Pau1oo/nrf52840-physiological-monitor/docs/Макет.pdf

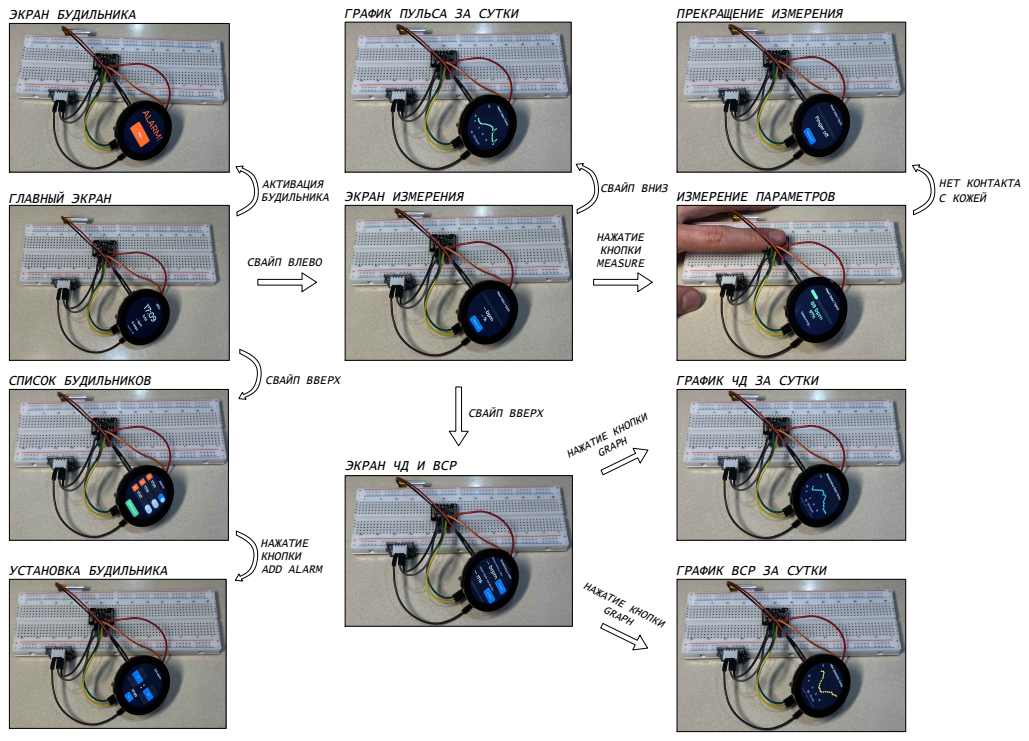
[picture p1: page 1]
ГЛАВНЫЙ ЭКРАН; СПИСОК БУДИЛЬНИКОВ; УСТАНОВКА БУДИЛЬНИКА; СВАЙП ВЛЕВО; ЭКРАН ИЗМЕРЕНИЯ; СВАЙП ВНИЗ; СВАЙП ВВЕРХ; ИЗМЕРЕНИЕ ПАРАМЕТРОВ; ЭКРАН БУДИЛЬНИКА; ПРЕКРАЩЕНИЕ ИЗМЕРЕНИЯ; НАЖАТИЕ КНОПКИ; НЕТ КОНТАКТА С КОЖЕЙ; A'' A/ARM

ГРАФИК ПУЛЬСА ЗА СУТКИ

ГРАФИК ЧД ЗА СУТКИ

ЭКРАН ЧД И ВСР

ГРАФИК ВСР ЗА СУТКИ
