Pau1oo/nrf52840-physiological-monitor/docs/Принципиальная схема.pdf

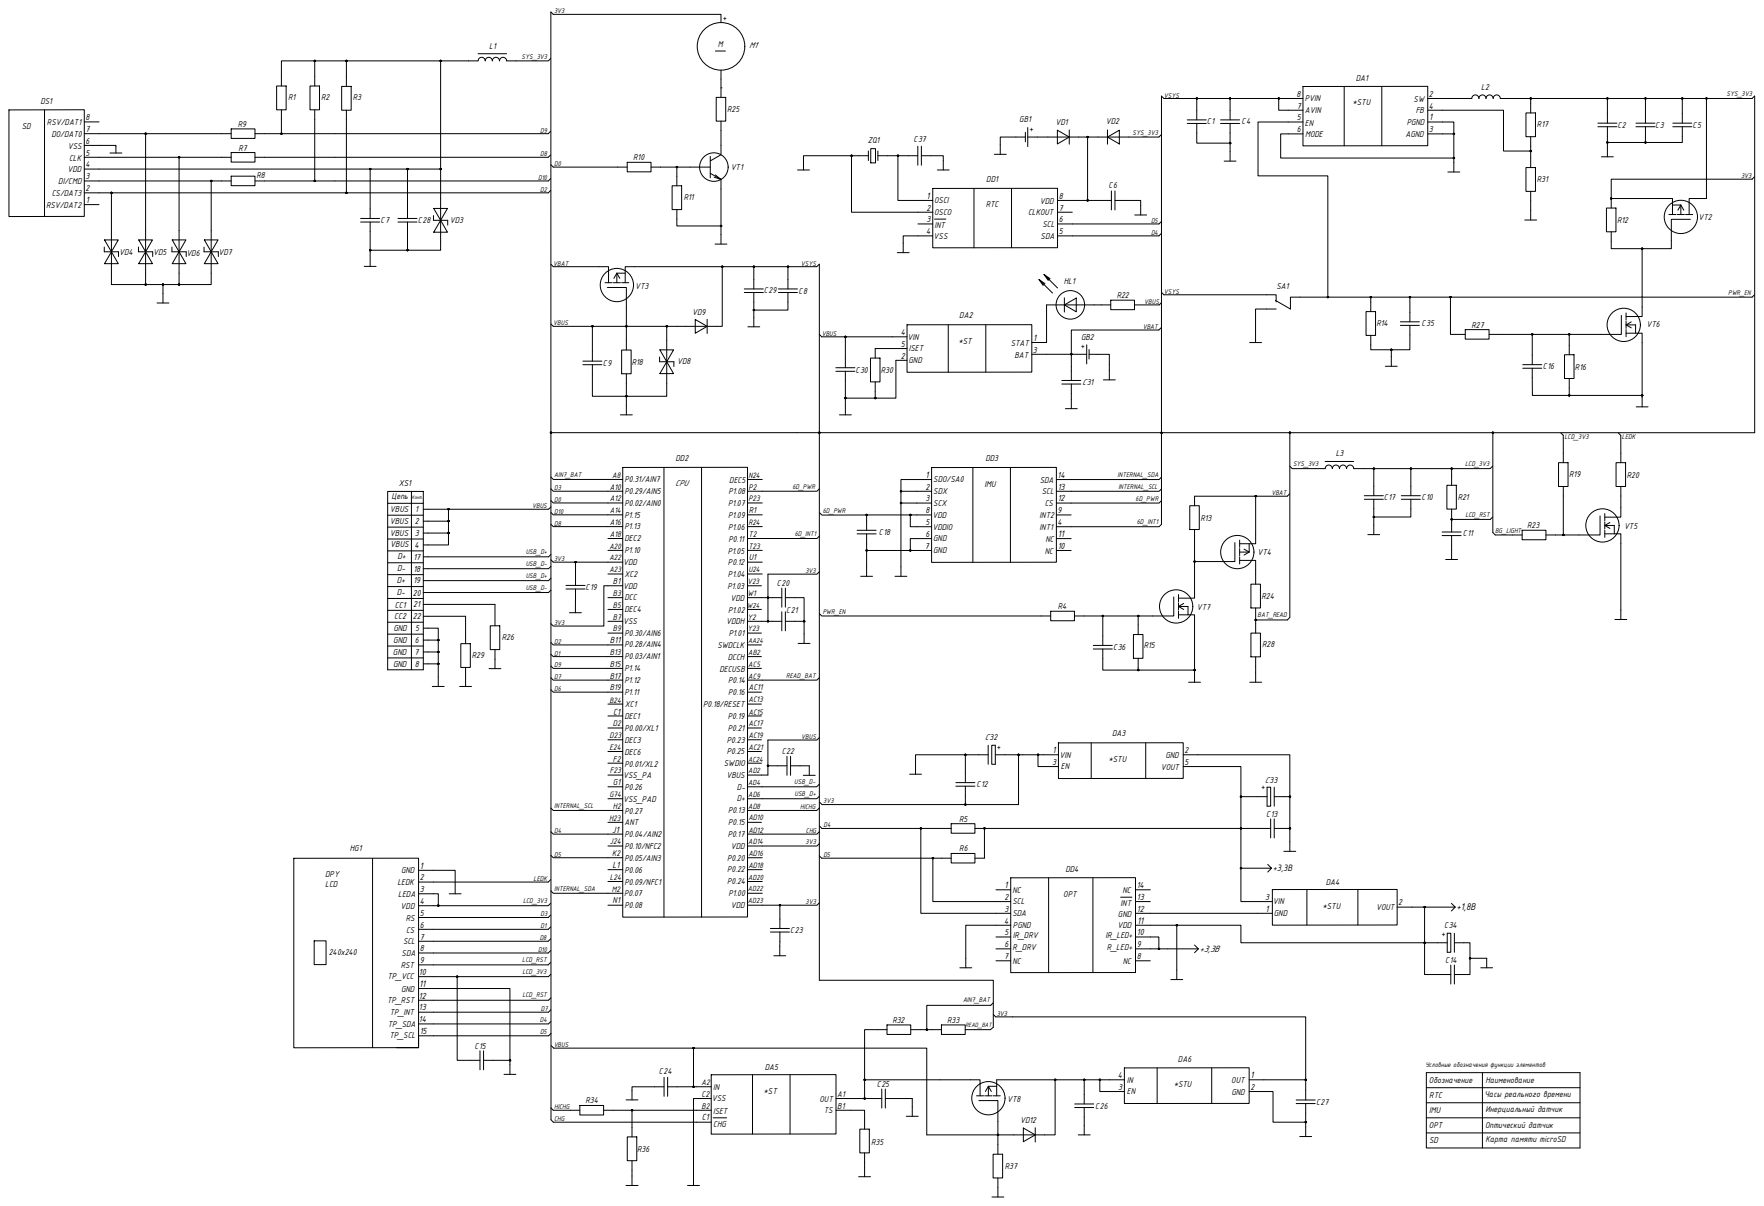
[picture p2: page 1]

DD2 | DD3 | VBAT | LCD_3V3

SDO/SA0 SDX SCX VDD VDDIO GND GND | IMU | SDA SCL CS INT2 INT1 NC

5 | | 10

Условные обозначения функции элементов

IN | OUT

Обозначение | Наименование

IN VSS ISET | *ST | OUT TS

IMU | Инерциальный датчик
