Pau1oo/nrf52840-physiological-monitor/docs/Схемы подключения.pdf

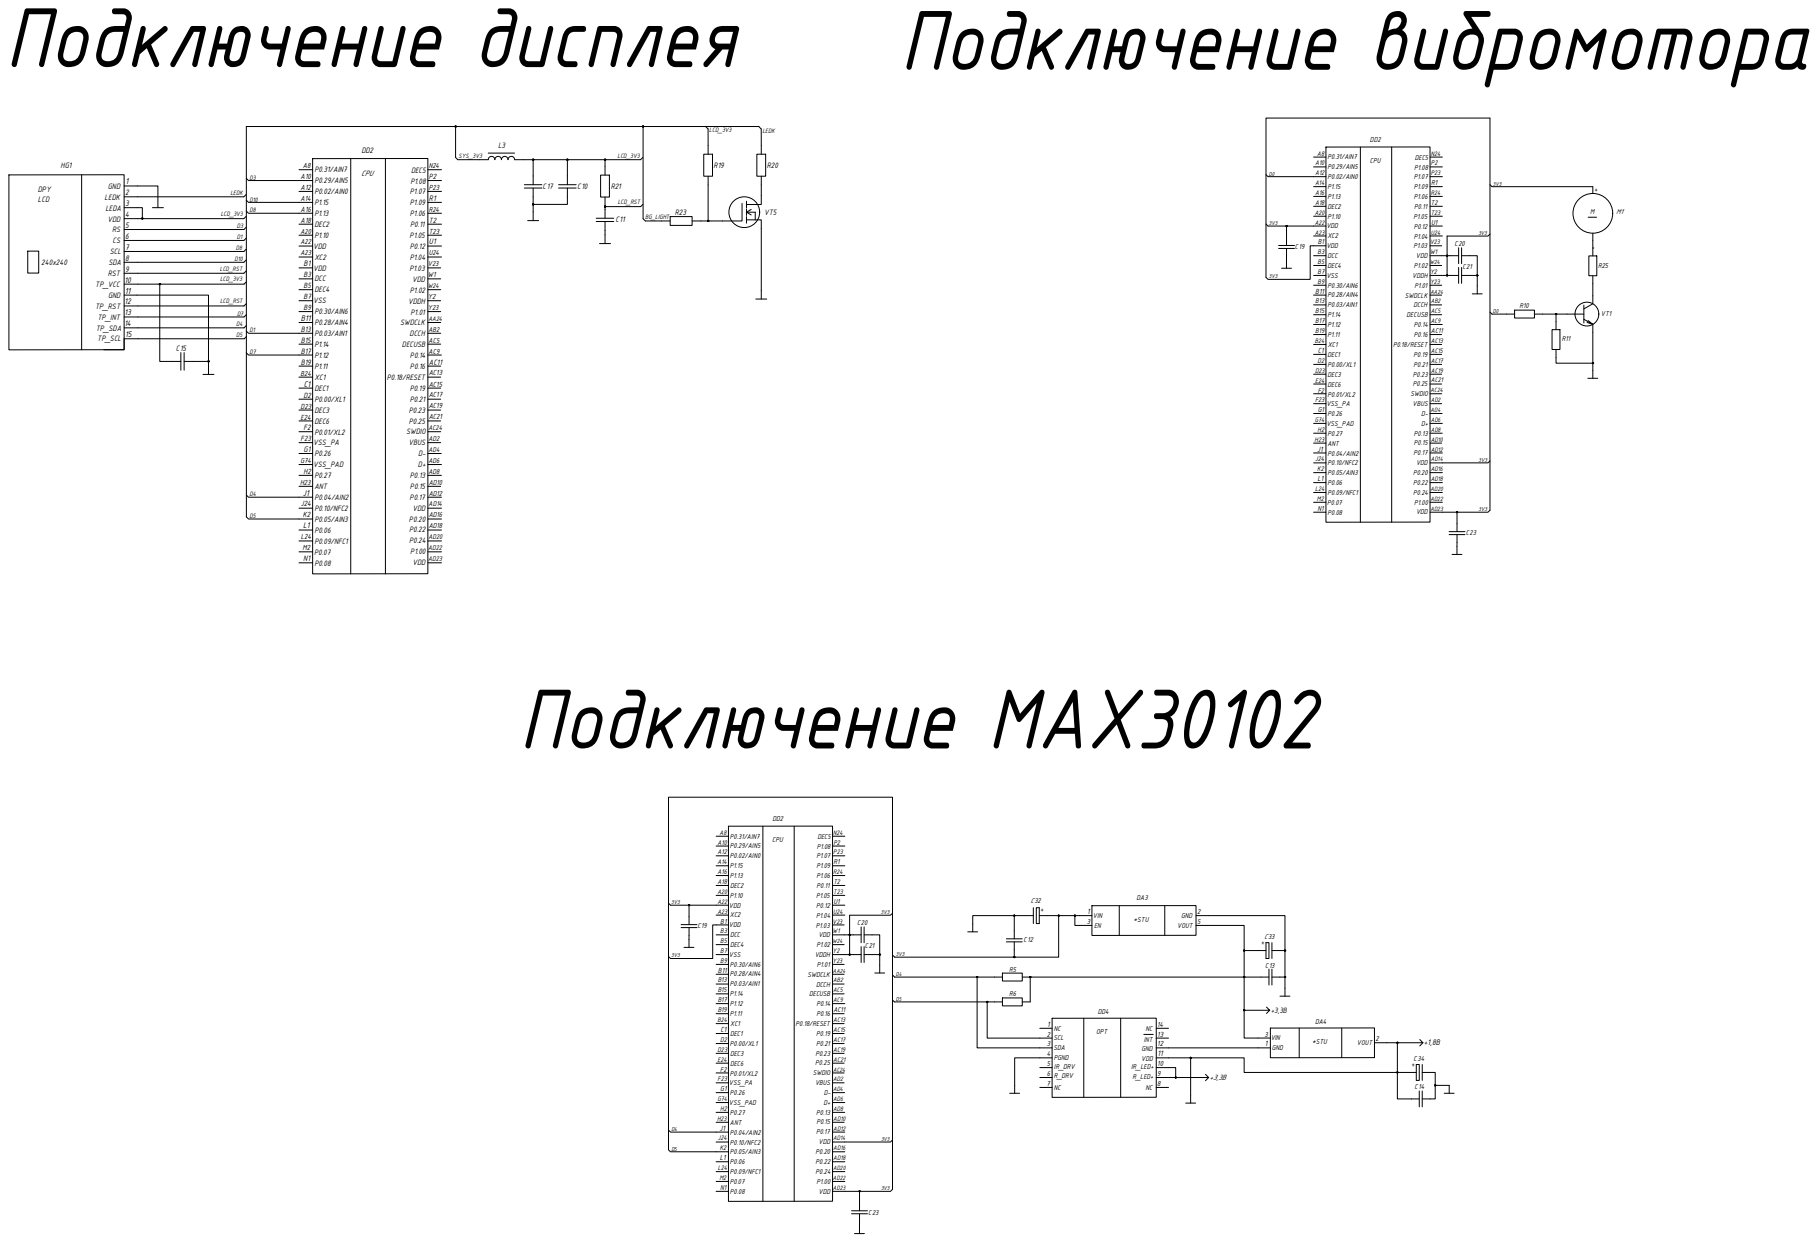
[picture p3: page 1]

P0.31/AIN7 P0.29/AIN5 P0.02/AIN0 P1.15 P1.13 DEC2 P1.10 VDD XC2 VDD DCC DEC4 VSS | CPU | DEC5 P1.08 P1.07 P1.09 P1.06 P0.11 P1.05 P0.12 P1.04 P1.03 VDD P1.02 VDDH

P0.31/AIN7 P0.29/AIN5 P0.02/AIN0 P1.15 P1.13 DEC2 P1.10 VDD XC2 VDD DCC DEC4 VSS P0.30/AIN6 P0.28/AIN4 P0.03/AIN1 P1.14 P1.12 P1.11 XC1 DEC1 P0.00/XL1 DEC3 DEC6 P0.01/XL2 VSS_PA P0.26 VSS_PAD P0.27 ANT P0.04/AIN2 P0.10/NFC2 P0.05/AIN3 P0.06 P0.09/NFC1 P0.07 P0.08 | CPU | DEC5 P1.08 P1.07 P1.09 P1.06 P0.11 P1.05 P0.12 P1.04 P1.03 VDD P1.02 VDDH P1.01 SWDCLK DCCH DECUSB P0.14 P0.16 P0.18/RESET P0.19 P0.21 P0.23 P0.25 SWDIO VBUS D-D+ P0.13 P0.15 P0.17 VDD P0.20 P0.22 P0.24 P1.00 VDD

DPY LCD | GND LEDK LEDA VDD RS CS SCL SDA RST TP_VCC GND TP_RST TP_INT TP_SDA TP_SCL

3 4

P0.30/AIN6 P0.28/AIN4 P0.03/AIN1 P1.14 P1.12 P1.11 XC1 DEC1 P0.00/XL1 DEC3 DEC6 P0.01/XL2 VSS_PA P0.26 VSS_PAD P0.27 ANT P0.04/AIN2 P0.10/NFC2 P0.05/AIN3 P0.06 P0.09/NFC1 P0.07 P0.08 | | P1.01 SWDCLK DCCH DECUSB P0.14 P0.16 P0.18/RESET P0.19 P0.21 P0.23 P0.25 SWDIO VBUS D-D+ P0.13 P0.15 P0.17 VDD P0.20 P0.22 P0.24 P1.00 VDD

11
12
13 | | D7
14 | | D4
15 | | D5

P0.31/AIN7 P0.29/AIN5 P0.02/AIN0 P1.15 P1.13 DEC2 P1.10 VDD XC2 VDD DCC DEC4 VSS P0.30/AIN6 P0.28/AIN4 P0.03/AIN1 P1.14 P1.12 P1.11 XC1 DEC1 P0.00/XL1 DEC3 DEC6 P0.01/XL2 VSS_PA P0.26 VSS_PAD P0.27 ANT P0.04/AIN2 P0.10/NFC2 P0.05/AIN3 P0.06 P0.09/NFC1 P0.07 | CPU | DEC5 P1.08 P1.07 P1.09 P1.06 P0.11 P1.05 P0.12 P1.04 P1.03 VDD P1.02 VDDH P1.01 SWDCLK DCCH DECUSB P0.14 P0.16 P0.18/RESET P0.19 P0.21 P0.23 P0.25 SWDIO VBUS D-D+ P0.13 P0.15 P0.17 VDD P0.20 P0.22 P0.24 P1.00

NC SCL SDA PGND IR_DRV R_DRV NC | OPT | NC INT GND VDD IR_LED+ R_LED+ NC

5 | | 10

P0.08 | VDD
