Pau1oo/nrf52840-physiological-monitor/docs/Перечень элементов.pdf

Изм.Лист | № докум. | Подп. | Дата
Разраб.
Пров.
Лит. | Лист | Листов
Кол. | Примечание

Поз.
обозна-чение

Наименование

Формат А4

Система измерения и анализа физиологических параметров состояния человека
Перечень элементов

Т.контр.
Н.контр.
Утв.

Конденсаторы

С28...С31 | Чип керамический 0402-X5R-4,7мкФ ±20% | 4 | Murata
| Чип керамический 0402-X5R-1мкФ ±20% | 1 | Murata
| Чип керамический 0402-X5R-10мкФ ±20% | 1 | Yageo
Чип керамический 0603-X5R-10мкФ ±20% | 3 | Kemet
Чип керамический 0402-NP0-18пФ ±5% | 1 | Murata
Чип керамический 0402-NP0-100пФ ±5% | 2 | Kemet
Чип керамический 0402-X7R-100нФ ±10% | 12 | Murata
Чип керамический 0201-X7R-100нФ ±10% | 1 | Kemet
Чип керамический 0201-X5R-2,2мкФ ±20% | 9 | Murata
Чип танталовый 3216-16V-10мкФ ±20% | 3 | Vishay

C16
C17

C1...C3

C37

C35, С36

С4...С15

С18

С32...С34

С19...С27

Микросхемы

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
| ETA3410 | 1 | ETA Solutions
| ETA4054S2F | 1 | ETA Solutions
| AP2112K
| TLV70018 | 1
| | 1 | Diodes Inc.
| | | Texas Instruments
| BQ25101YFPT | 1 | Texas Instruments
| SGM2040-3.3YUDH4G/TR | 1 | SGMicro
| PCF8563 | 1 | NXP Semiconductors
| nRF52840 | 1 | Nordic Semiconductor
| LSM6DS3TR-C | 1 | STMicroelectronics
| MAX30102 | 1 | Maxim Integrated
| QM16GMICSDHC10U1 | 1 | QUMO
GB1 | Батарея литиевая CR927 | 1 | SCRCEO

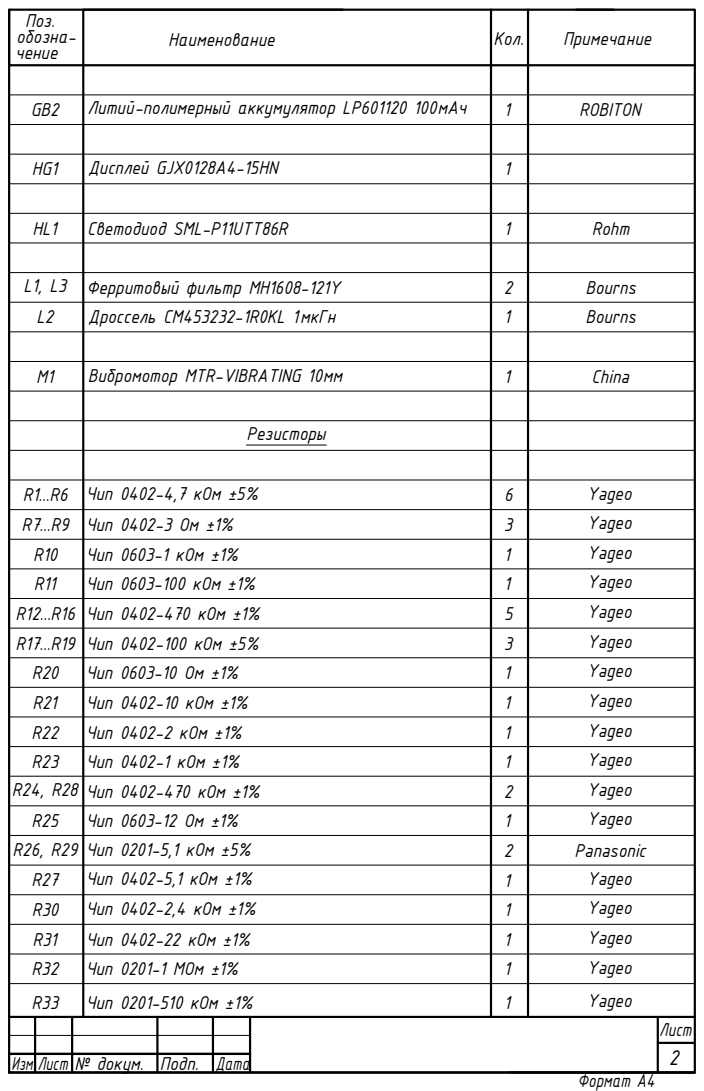
[picture p4: page 2]

Чип 0402-4,7 кОм ±5% | 6
Чип 0402-3 Ом ±1% | 3
Чип 0603-1 кОм ±1% | 1
Чип 0603-100 кОм ±1% | 1
Чип 0402-470 кОм ±1% | 5
Чип 0402-100 кОм ±5% | 3
Чип 0603-10 Ом ±1% | 1
Чип 0402-10 кОм ±1% | 1
Чип 0402-2 кОм ±1% | 1
Чип 0402-1 кОм ±1% | 1
Чип 0402-470 кОм ±1% | 2
Чип 0603-12 Ом ±1% | 1
Чип 0201-5,1 кОм ±5% | 2
Чип 0402-5,1 кОм ±1% | 1
Чип 0402-2,4 кОм ±1% | 1
Чип 0402-22 кОм ±1% | 1
Чип 0201-1 МОм ±1% | 1

Чип 0201-510 кОм ±1%

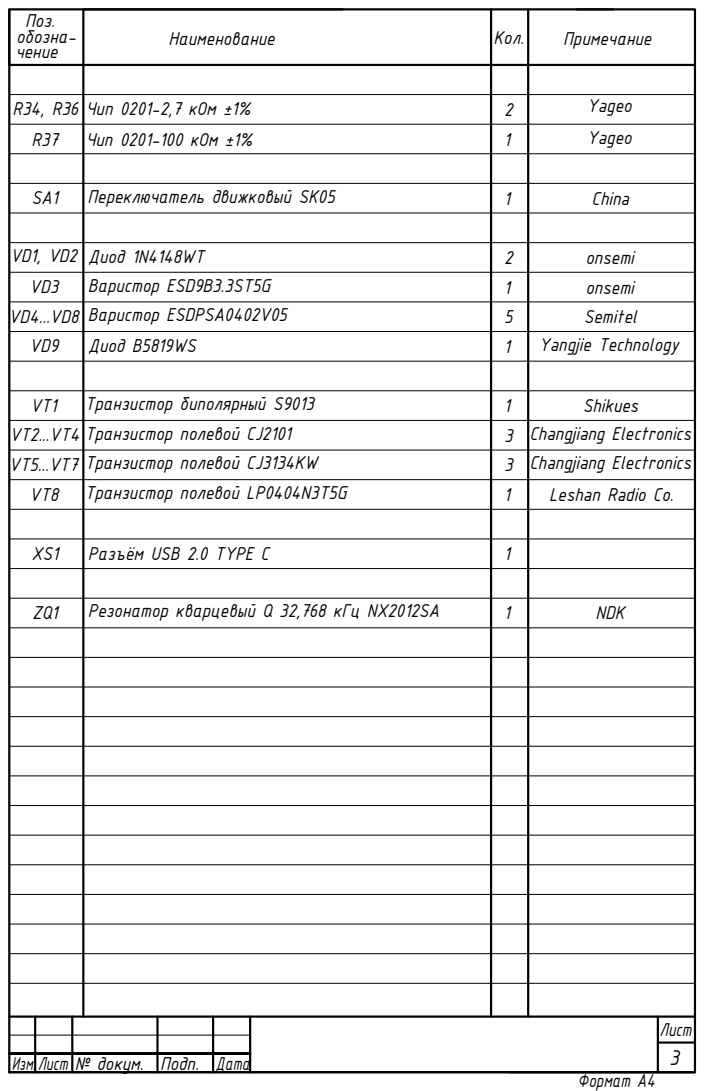
[picture p5: page 3]
Изм. Лист; № докум.; Подп.; Дата; Переключатель движковый SK05; Резонатор кварцевый Q 32,768 кГц NX2012SA; NDK; Разъём USB 2.0 TYPE C; Yangjie Technology; Чип 0201-2,7 кОм ±1%; Yageo; Чип 0201-100 кОм ±1%

Диод 1N4148WT | 2
Варистор ESD9B3.3ST5G | 1
Варистор ESDPSA0402V05 | 5
Диод B5819WS

Транзистор биполярный S9013
Транзистор полевой CJ2101 | 3
Транзистор полевой CJ3134KW | 3
Транзистор полевой LP0404N3T5G | 1

Changjiang Electronics
Leshan Radio Co.
